ThomasCrisafulli/Ohmmeter/Ohmmeter Project Pictures/Ohmmeter Measuring Resistor 1.png

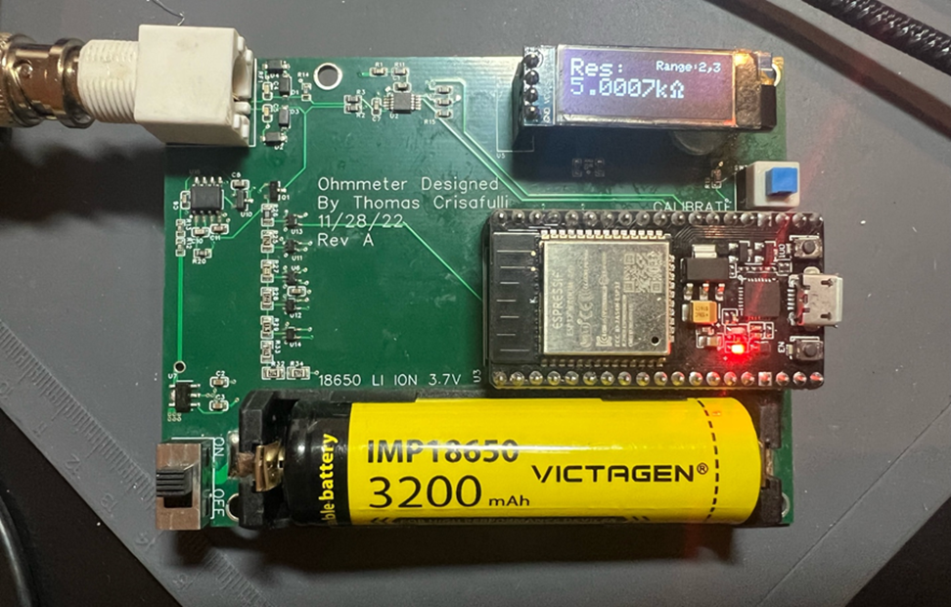
Ohmmeter Project Pictures/Ohmmeter Measuring Resistor 1.png
