ThomasCrisafulli/Ohmmeter/Ohmmeter Project Pictures/3D PCB Render-Orthographic View.png

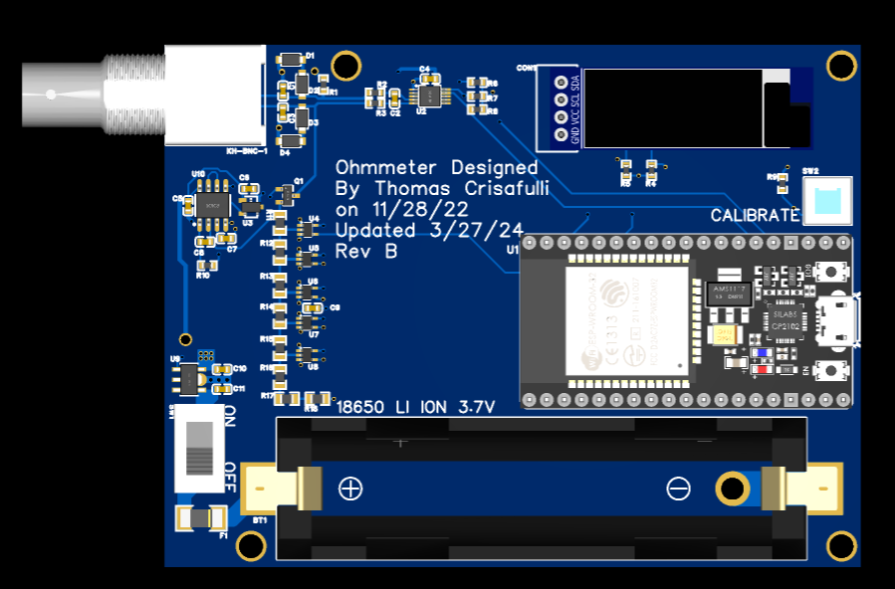
Ohmmeter Project Pictures/3D PCB Render-Orthographic View.png
