ThomasCrisafulli/Ohmmeter/Ohmmeter Project Pictures/3D PCB Render-Perspective View 4.png

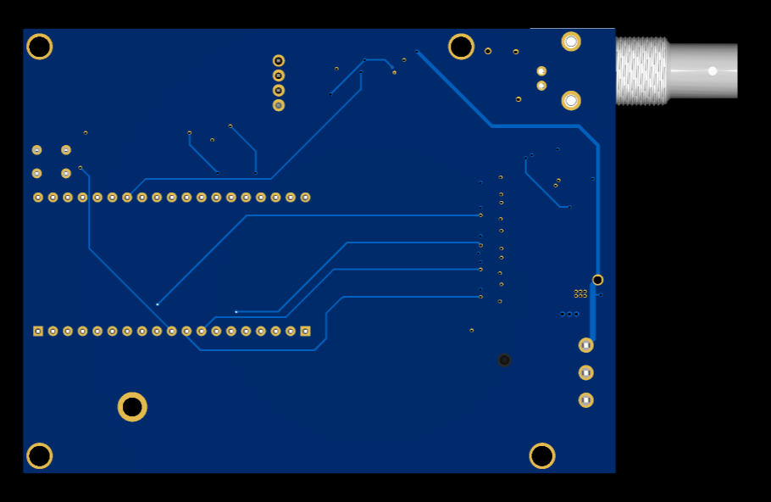
Ohmmeter Project Pictures/3D PCB Render-Perspective View 4.png
