ThomasCrisafulli/Ohmmeter/Ohmmeter Project Pictures/PCB Top & Bottom Layers View.png

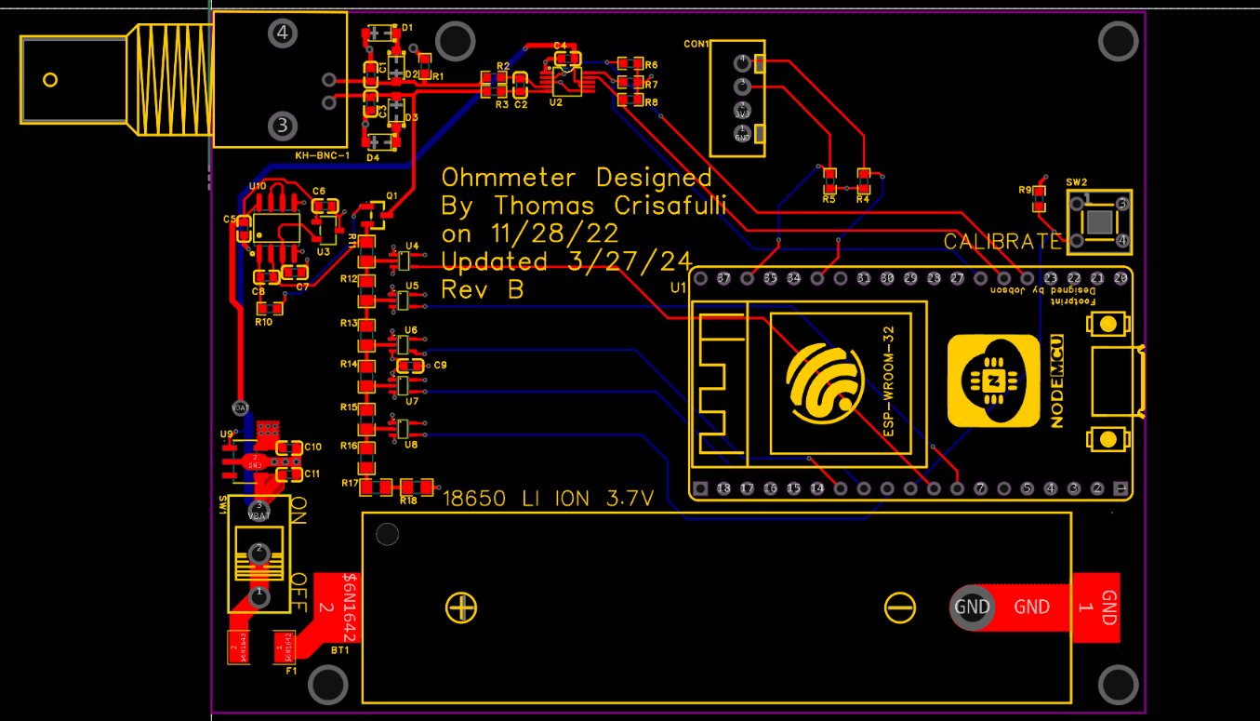
Ohmmeter Project Pictures/PCB Top & Bottom Layers View.png
