ThomasCrisafulli/Ohmmeter/Ohmmeter Project Files and Schematics/Ohmmeter_Schematic_V1_1.pdf

## ADC Low Pass Filter

## Input Protection

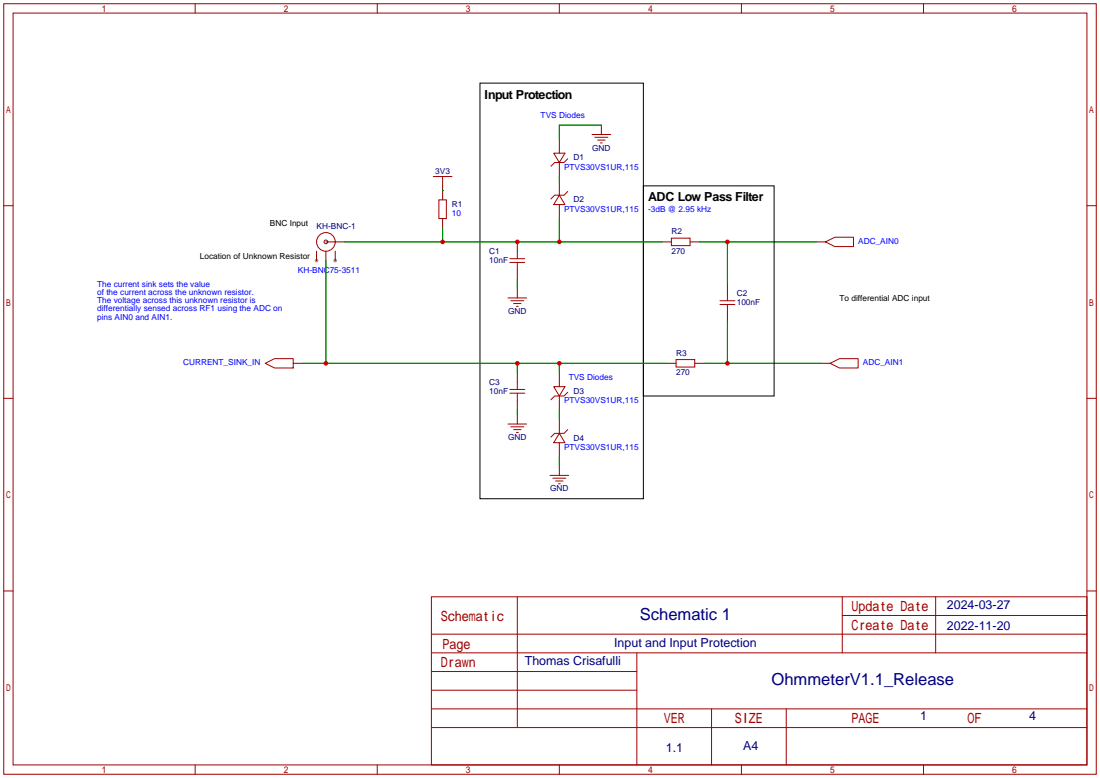
[picture p8: page 1]

Location of Unknown Resistor

The current sink sets the value
of the current across the unknown resistor.
The voltage across this unknown resistor is
differentially sensed across RF1 using the ADC on
pins AIN0 and AIN1.

To differential ADC input

Schematic 1
Input and Input Protection

## ESP32

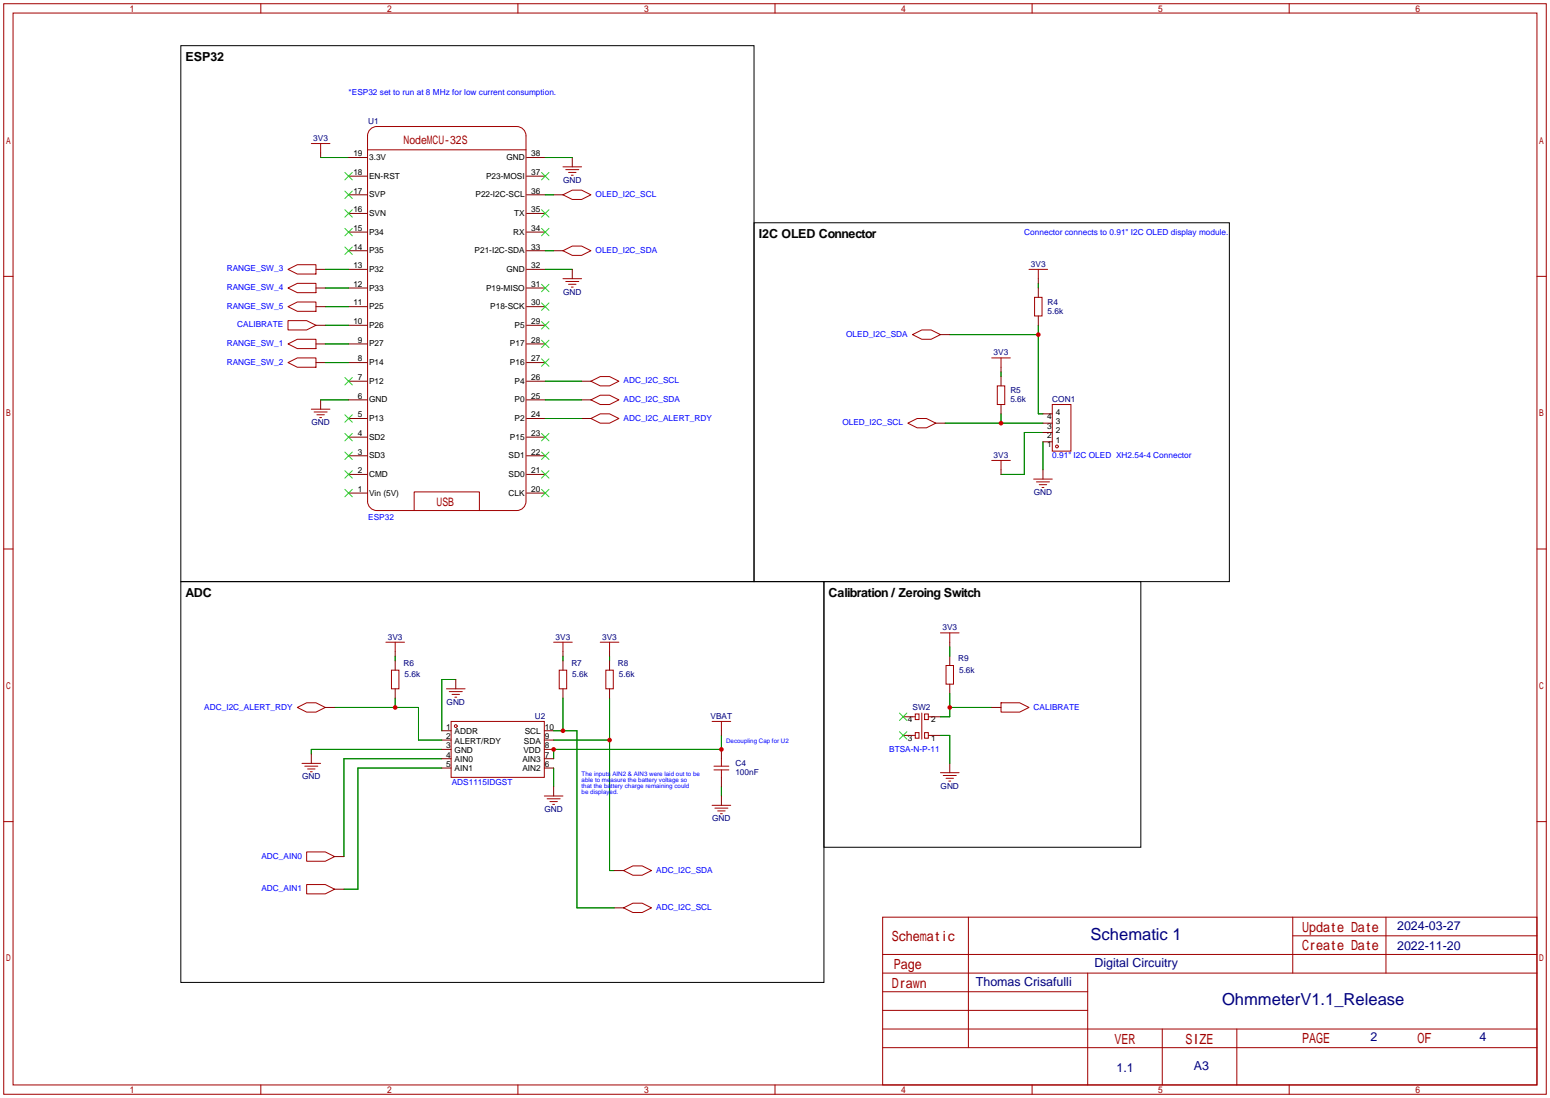
[picture p9: page 2]

*ESP32 set to run at 8 MHz for low current consumption.

Connector connects to 0.91" I2C OLED display module. I2C OLED Connector

The inputs AIN2 & AIN3 were laid out to be
able to measure the battery voltage so
that the battery charge remaining could
be displayed.

## Constant Current Sink

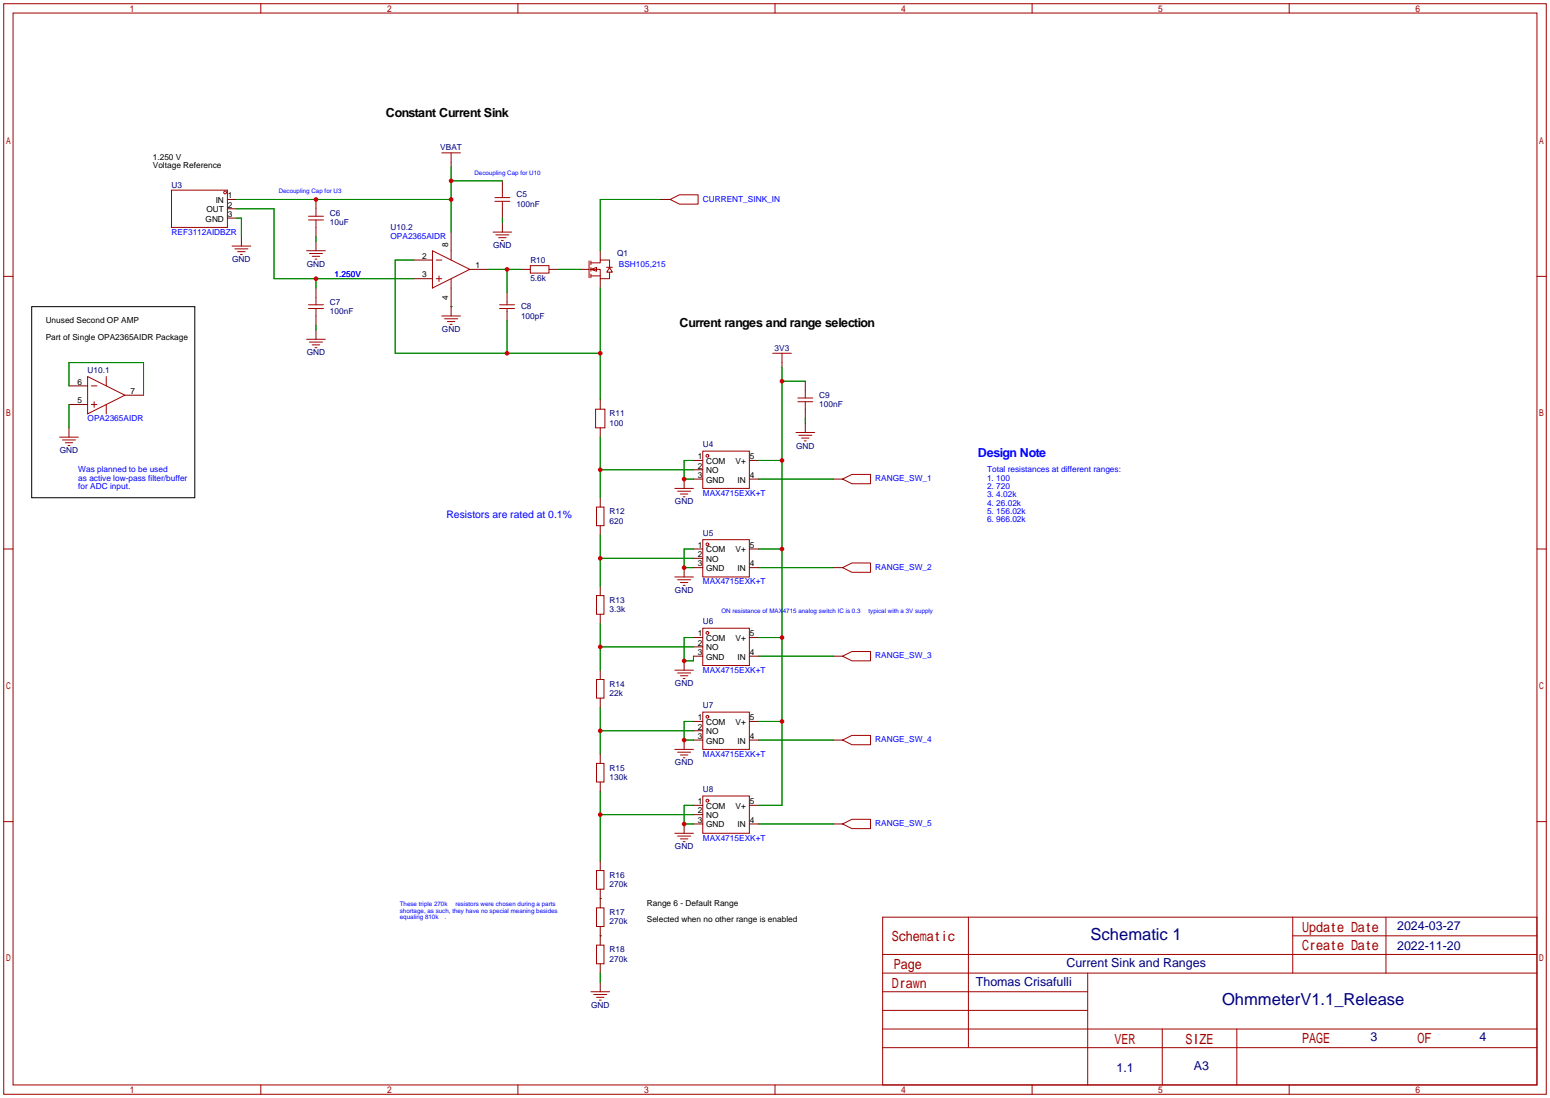
[picture p10: page 3]

Unused Second OP AMP
Part of Single OPA2365AIDR Package

Current ranges and range selection

GND
Was planned to be used
as active low-pass filter/buffer
for ADC input.

Resistors are rated at 0.1%

ON resistance of MAX4715 analog switch IC is 0.3 typical with a 3V supply
COM 1
GND 3
MAX4715EXK+T

These triple 270k resistors were chosen during a parts
shortage, as such, they have no special meaning besides
equaling 810k .

Range 6 - Default Range
Selected when no other range is enabled

Schematic 1
Current Sink and Ranges

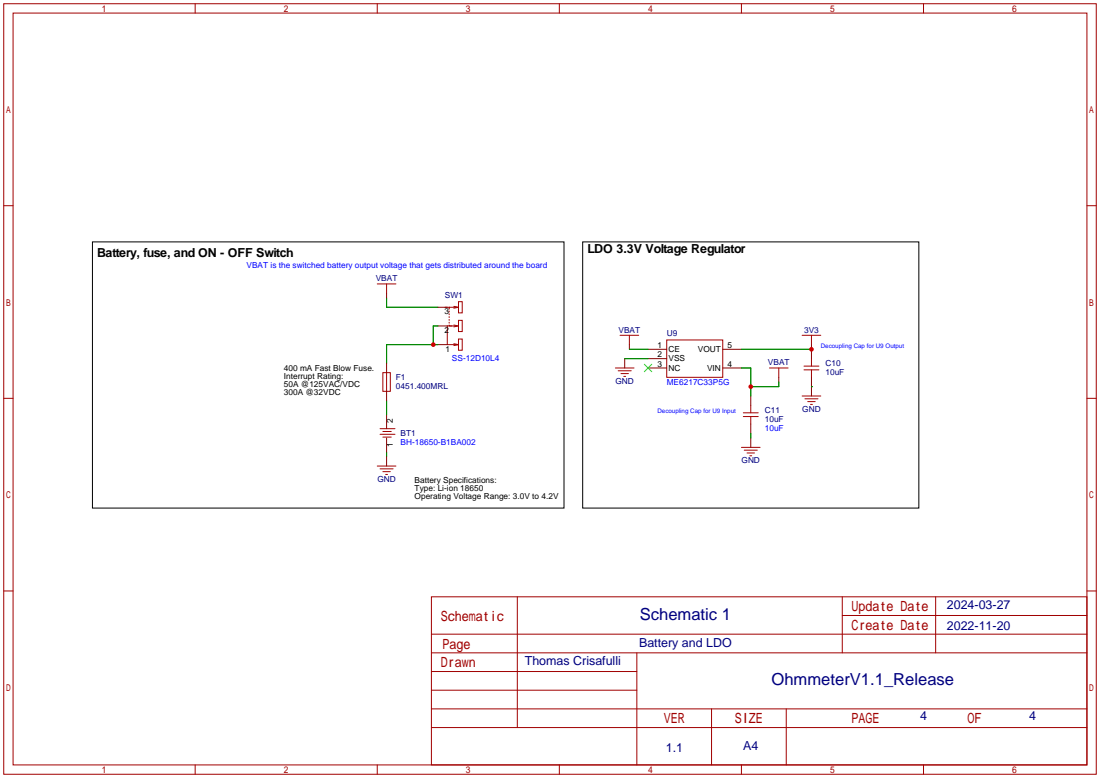
[picture p11: page 4]

VBAT is the switched battery output voltage that gets distributed around the board

Decoupling Cap for U9 Input

Battery Specifications:
Type: Li-ion 18650
Operating Voltage Range: 3.0V to 4.2V
