ThomasCrisafulli/Ohmmeter/(list of files, drawings)

Other design files:
Ohmmeter Project Files and Schematics/OhmmeterV1_1.epro
