ThomasCrisafulli/Ohmmeter/(commit log)

2024-02-12 Changed the formatting of the README to move the PCB picture closer to the top
2024-02-12 Added text explaining the device's operation and fixed a typo in the project requirements section
    Added a body paragraph explaining the device's operation and corrected a mistake on the original project requirements.
2024-02-12 Fixed a typo in the description of the README
    Corrected description to read analog switch ICs, because a solid-state relay is a very different component.
2024-03-28 Added the project files and schematics for the board
    Note: This addition and update attempts to mostly preserve the original design when the project was handed in for grading in December 2022, but also makes a few necessary changes.
    Summary:
    This revision, Revision B, corrects 2 bugs, makes some minor improvements, and considerably improves the readability and tidiness of the schematics so that they can be uploaded. Additionally, some traces were rerouted and cleaned up for neatness. For context, the picture of the working prototype in the README is the original board, marked “Rev A.”
    Bugs Fixed:
    The first bug fixed was the pin choices for two of the ESP32 pins that control RANGE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
    [Ohmmeter BOM V1_1.csv, OhmmeterV1_1.epro]
2024-03-29 Update README.md to show that the project schematics have been added
2024-03-30 Update README to give a status report on the device software
